chrcava/suction_cup_gripper/RMTA1-20T2.stp

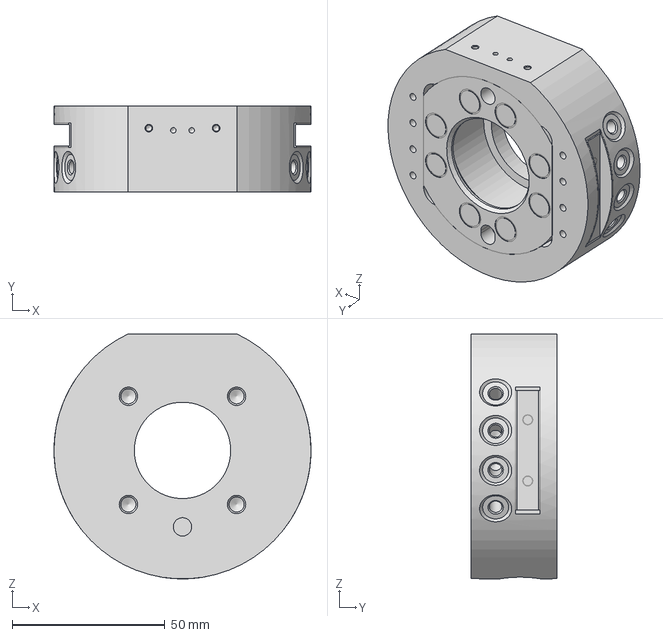
[picture p3: CAD file, 2026-03-19]
RMTA1-20T2.stp
84.0 x 28.0 x 80.0 mm
