chrcava/suction_cup_gripper/Custom_gripper.step

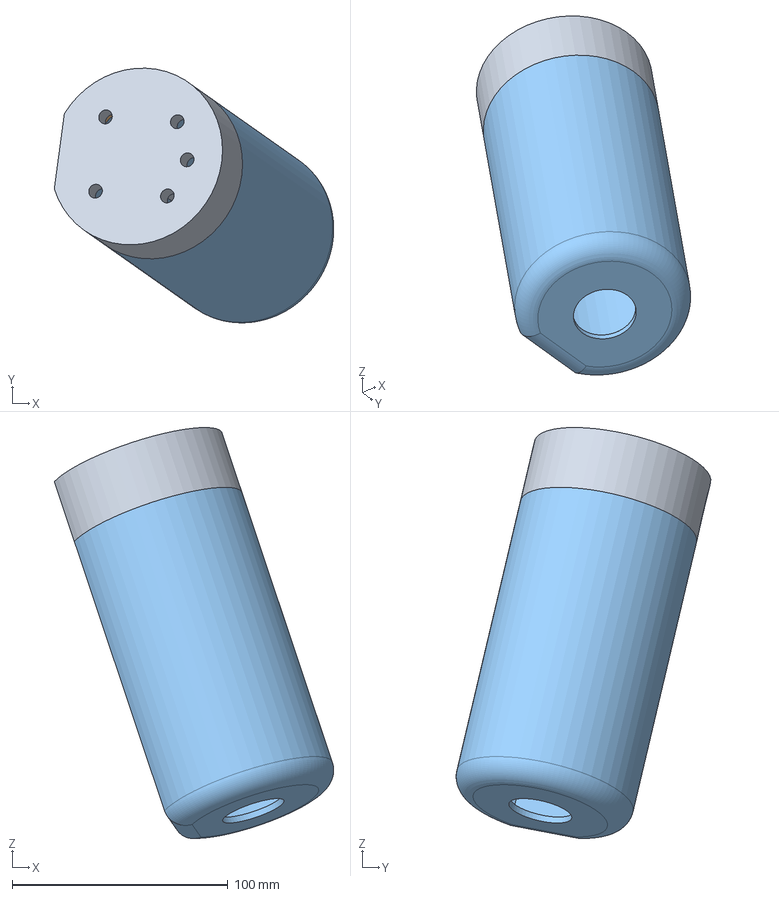
[picture p4: CAD file, 2026-03-19]
Custom_gripper.step
129.7 x 118.2 x 190.7 mm
