chrcava/suction_cup_gripper/G.BGI80S50.B3.S1.G38F.00.stp

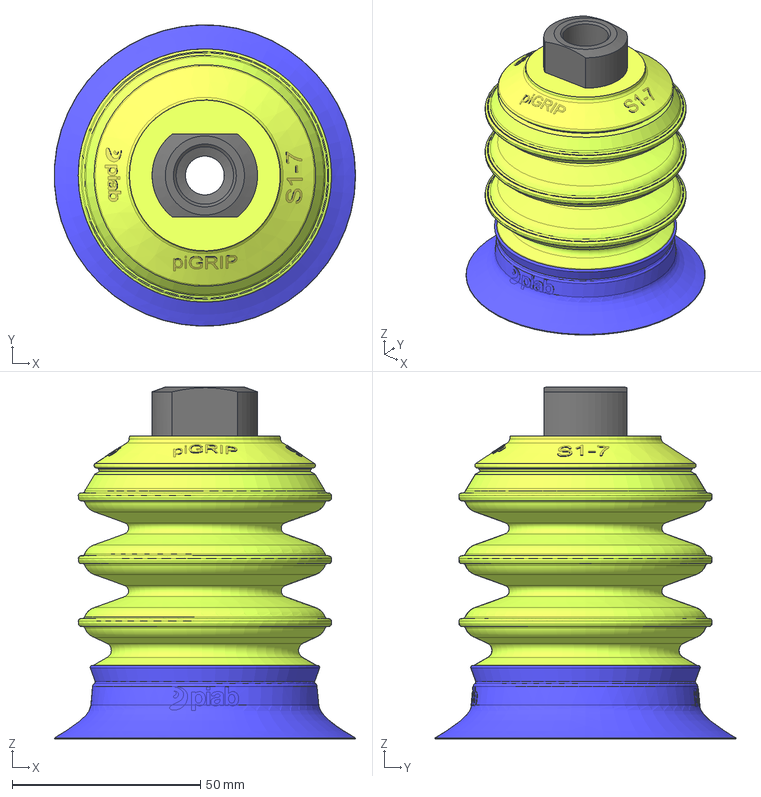
[picture p5: CAD file, 2026-03-19]
G.BGI80S50.B3.S1.G38F.00.stp
79.9 x 80.0 x 93.4 mm
lip_BGI80S50
bellow_B3-7
support_S1-7
fitting_G38F
