chrcava/suction_cup_gripper/RMTA1-20M1.stp

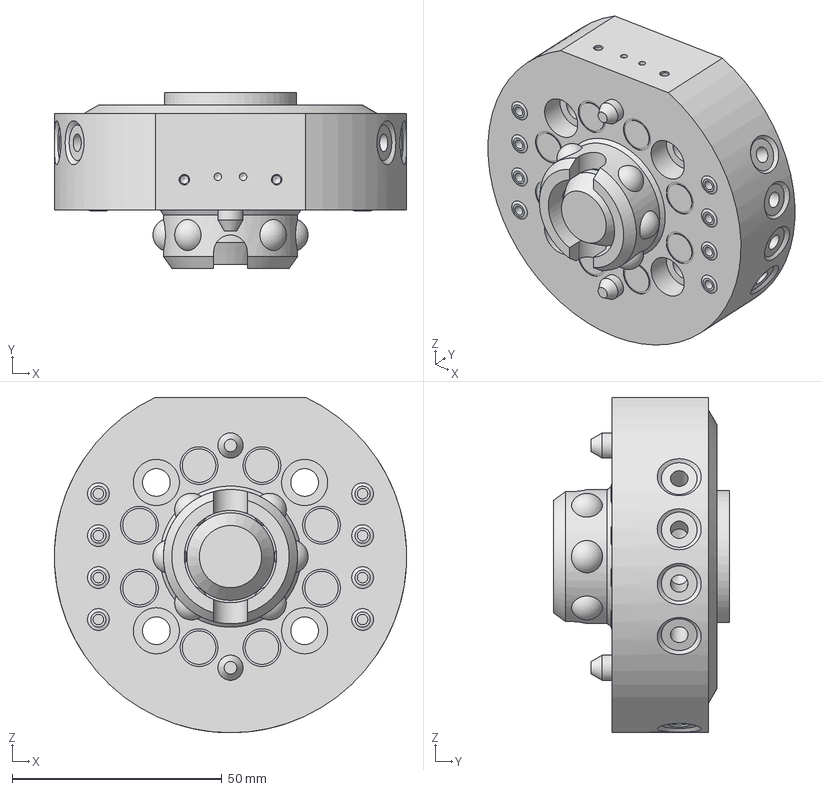
[picture p6: CAD file, 2026-03-19]
RMTA1-20M1.stp
83.9 x 42.0 x 80.0 mm
