chrcava/suction_cup_gripper/0124960_M.stp

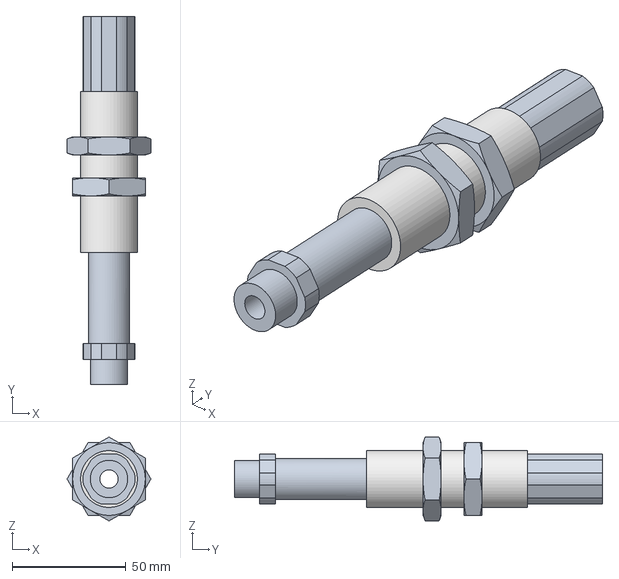
[picture p7: CAD file, 2026-03-19]
0124960_M.stp
37.0 x 162.0 x 37.0 mm
