chrcava/suction_cup_gripper/0107053.stp

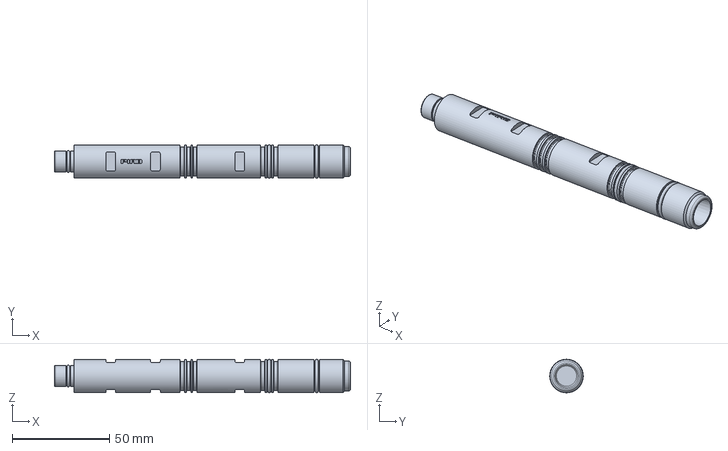
[picture p8: CAD file, 2026-03-19]
0107053.stp
152.5 x 17.3 x 17.3 mm
