chrcava/suction_cup_gripper/Cavalluzzo_drawing.pdf

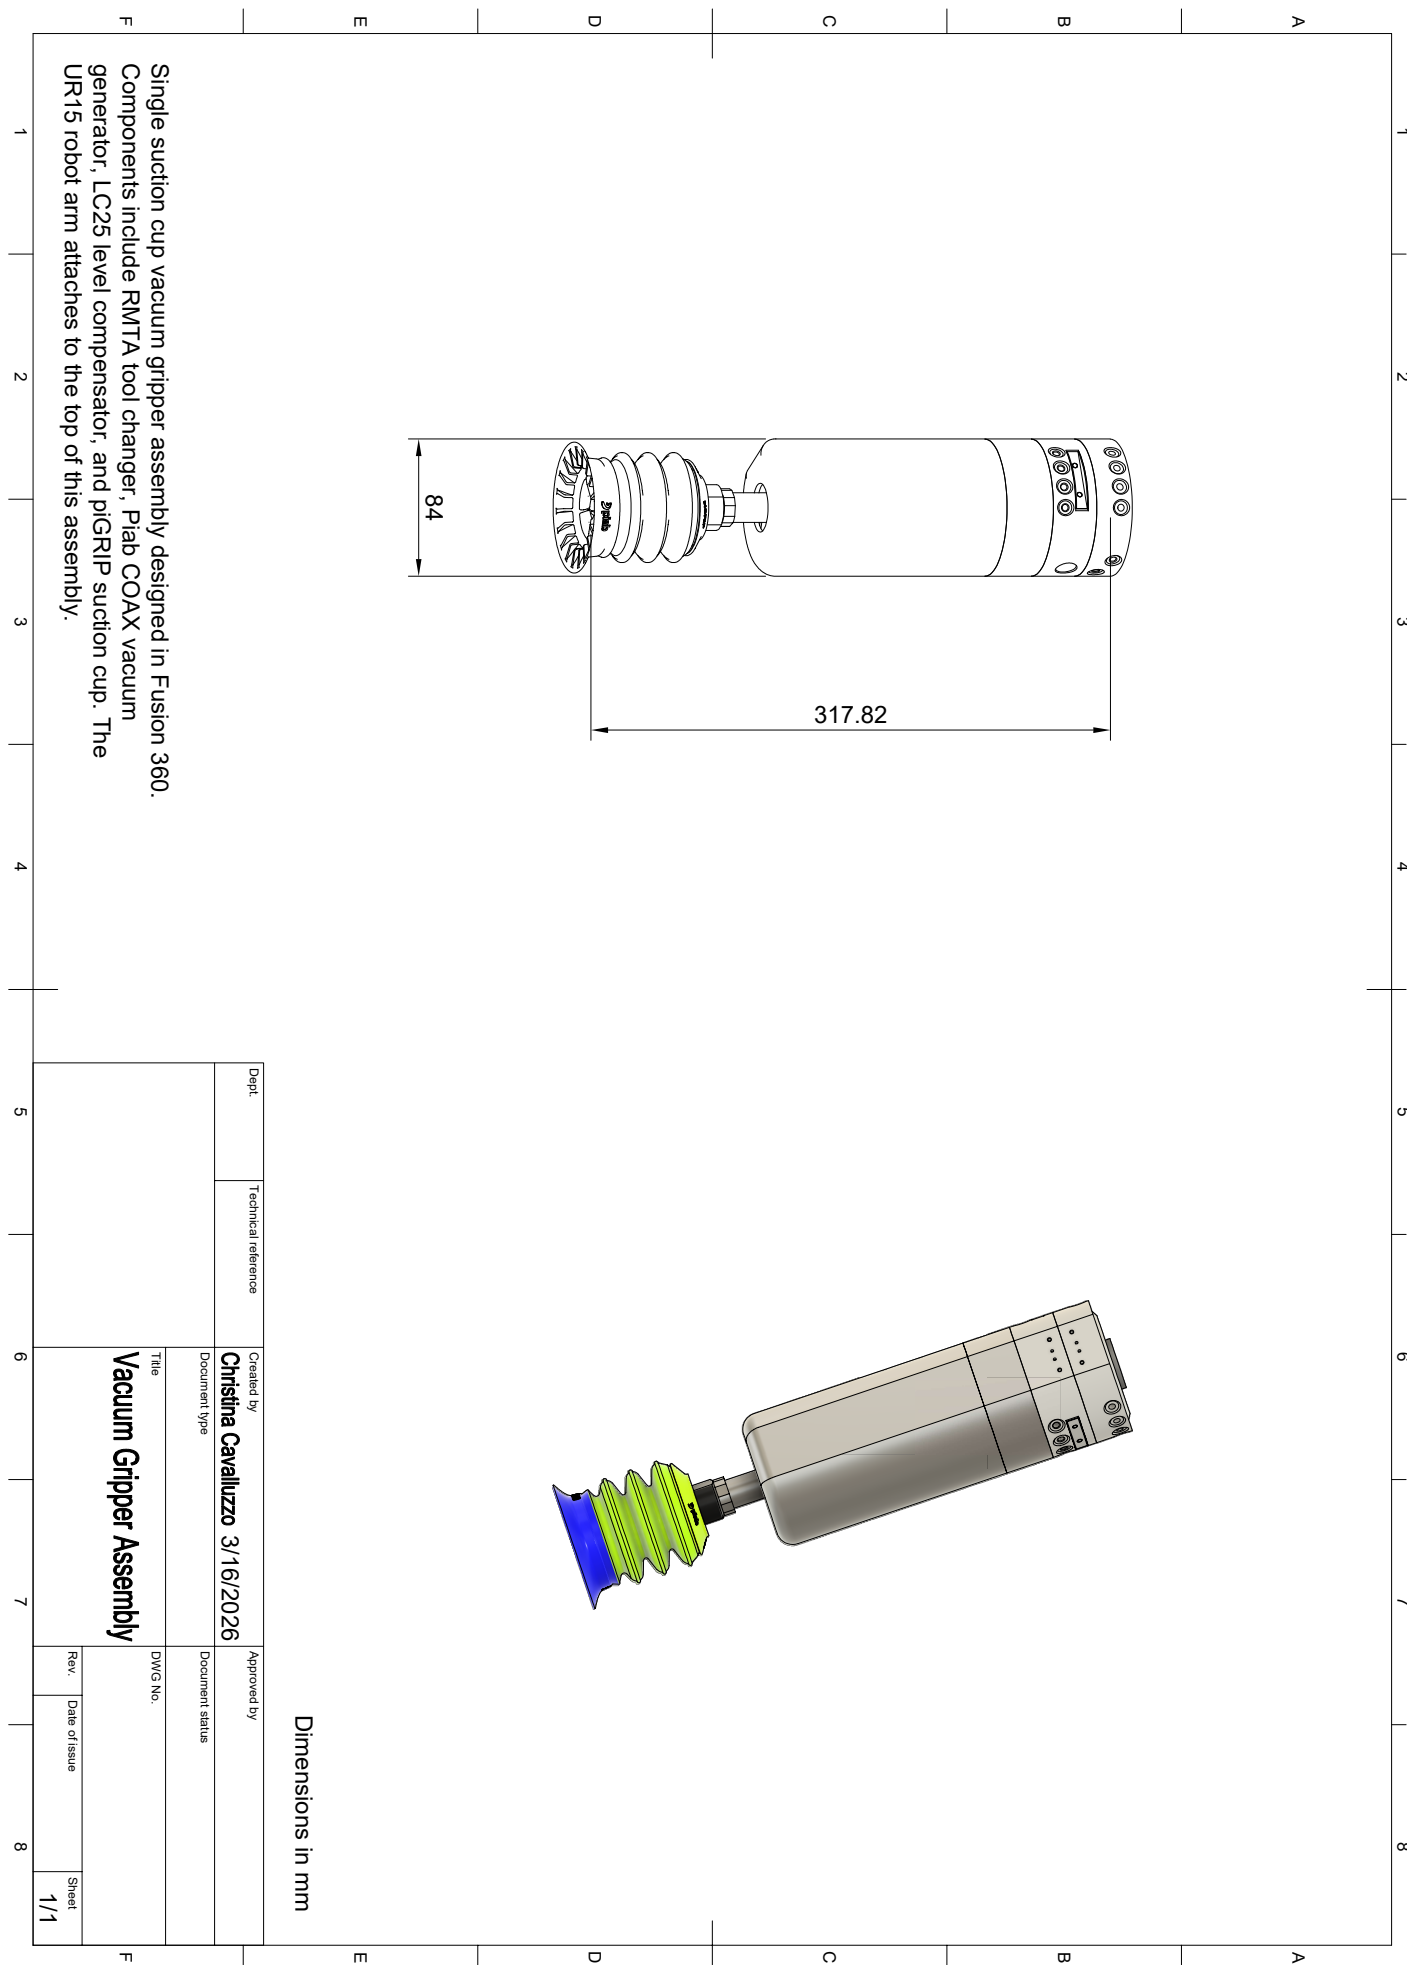
[picture p9: page 1]
317.82 Dimensions in mm; 84 UR15 robot arm attaches to the top of this assembly. generator, LC25 level compensator, and piGRIP suction cup. The Components include RMTA tool changer, Piab COAX vacuum Single suction cup vacuum gripper assembly designed in Fusion 360.

1 A 2 3 4 5 6 7 8 1 2 3 4 5 6 7 8 FEDCB FEDCBA Dept. Technical reference Created by Approved by Title DWG No. Document type Document status Rev. Date of issue Sheet 3/16/2026 1/1
