chrcava/suction_cup_gripper/(notices)

Notices in the files:
RMTA1-20M1.stp:
author */ ('License CC BY-ND 4.0'),
